NickeyJin/MyFirstCar/机械臂接入说明.md

# 机械臂模块接入说明

> 这份说明是给**底盘（麦轮）那部分**看的：我动了哪些文件、为什么动、你要注意什么。

---

## 一、加了什么

| 文件 | 内容 |
|---|---|
| `Core/Inc/servo.h`、`Core/Src/servo.c` | 舵机控制（3 关节、软限位、缓动、夹爪）|
| `Core/Inc/teach_only.h`、`Core/Src/teach_only.c` | 示教录制 / 回放 + Flash 存取 |

**4 个新文件，没有覆盖任何已有文件。**

---

## 二、动了哪些**已有**文件（一共 3 处，都很小）

### ① `CMakeLists.txt` —— 加了 4 行

```cmake
  Core/Src/app.c
  # ---- 机械臂舵机 + 示教录制回放（自带 TIM4 初始化，不依赖 CubeMX）----
  Core/Inc/servo.h
  Core/Inc/teach_only.h
  Core/Src/servo.c
  Core/Src/teach_only.c)
```

### ② `STM32F103xx_FLASH.ld` —— ⚠️ **FLASH 从 64K 改成 62K**

```ld
FLASH (rx) : ORIGIN = 0x8000000, LENGTH = 62K      ← 原来是 64K
```

**为什么必须改**：示教录制数据存在**最后 2 页 Flash**（`0x0800F800`，2 KB）。
如果不给程序区让出这 2 页，**一按"存"就会把程序自己擦掉**。

> ⚠️ **这个地址是写死的**，改一边就得改另一边，**别单独改回去**。

### ③ `Core/Src/app.c` —— 加了 3 行

```c
#include "teach_only.h"     /* 第 19 行，加在 #include "ps2.h" 后面 */

void app_init(void)
{
    dwt_init();
    ps2_init();
    teach_only_init();      /* ← 新增：舵机 + 从 Flash 读回上次录制 */
    chassis_init();
    ...
}

void app_task(void)
{
    ...
    ps2_poll();
    teach_only_poll();      /* ← 新增：★ 必须在 if (!ps2_ok) return; 之前 */
    if (!ps2_ok) { ... return; }
    ...
}
```

**★ 为什么 `teach_only_poll()` 要放在那句 `return` 之前**：
手柄一掉线，`app_task()` 就提前返回了。如果示教模块放在后面，**手柄掉线时机械臂的录制/回放也会跟着停摆**。

---

## 三、★ 它不抢你的资源

| 资源 | 归属 |
|---|---|
| **TIM1 / TIM2 / TIM3** | **你的**（电机 8 路 PWM）—— 本模块完全不碰 |
| **TIM4** | 本模块，**而且是自己初始化的**（不依赖 CubeMX）|
| **PB6 / PB7 / PB8** | 本模块（舵机信号），**不要占用** |
| PB9 | 空出备用 |
| **PA4 ~ PA7** | **共用**（PS2 手柄）—— 你的 `ps2_poll()` 已经在读了，本模块直接用 |
| **PA0~PA3 / PA8 / PA11 / PB0 / PB1** | 你的（电机）|
| **PC13（灯）** | ⚠️ **冲突**，见下 |
| **两个摇杆** | **你的** —— 本模块一个都不读 |
| **Flash 最后 2 页** | 本模块（录制数据）|

### ⚠️ PC13 状态灯冲突

你的 `app_task()` 里在写 PC13（`LED_ON()` / `LED_OFF()`），**示教模块也在写**（用来指示"待命/录制中/回放中"）。

两边每 20ms 各写一次 → **灯会闪得比较乱**。

**三个选择，你挑：**

| 方案 | 做法 |
|---|---|
| **A. 你的优先**（推荐）| 保持现状即可 —— 你的 LED 是每轮最后写的，基本会赢 |
| **B. 我的优先** | 把 `app_task()` 里的 `LED_ON()/LED_OFF()` 注释掉 |
| **C. 各用一个灯** | 我这边改到别的引脚（PB9 之类），你说一声我改 |

**目前按 A 处理，没有动你的 LED 代码。**

---

## 四、给底盘留的钩子（可选，但建议用）

写 Flash 时会**关中断 100~200ms**。电机 PWM 是硬件在发，会**保持最后的速度冲出去**。

在任意一个 `.c` 里写这个函数就自动生效（弱符号，不带 `__weak`）：

```c
void teach_before_save(void)
{
    chassis_stop();       /* 或者 ramp_vx = ramp_vy = ramp_w = 0; */
}
```

---

## 五、编译验证结果

```
warning = 0    error = 0

FLASH: 18848 B / 62 KB   （接入前 13240 B）
RAM:    3584 B / 20 KB

✅ arm_init  ✅ teach_only_init  ✅ teach_only_poll
✅ servo_poll  ✅ servo_hw_init   ✅ flash_save      全部链接进固件
```

## 六、接口速查

```c
/* 初始化（app_init 里调一次） */
teach_only_init();          /* 舵机 + 从 Flash 读回录制 */

/* 主循环（20ms 一次，必须在 if (!ps2_ok) return; 之前） */
teach_only_poll();          /* 读手柄按键 + 录制/回放推进 */

/* 可选：写 Flash 前让底盘停车 */
void teach_before_save(void);
```
