NickeyJin/MyFirstCar/(commit log)

2026-10-11 a little change
    修改了之前测试用的小数据
2026-10-11 随便测试一下
2026-10-12 最新的一版
2026-10-15 [arm] 接入机械臂：舵机控制 + 示教录制回放
    新增（不覆盖任何已有文件）：
    - Core/Inc/servo.h / Core/Src/servo.c 三关节舵机控制（软限位 + 缓动 + 夹爪）
    - Core/Inc/teach_only.h / Core/Src/teach_only.c 示教录制/回放 + Flash 存取
    修改（3 处）：
    - CMakeLists.txt 加 4 个文件
    - STM32F103xx_FLASH.ld FLASH 64K -> 62K（给录制数据让出最后 2 页）
    - Core/Src/app.c +include，app_init 加 teach_only_init()，
    app_task 在 if(!ps2_ok)return 之前加 teach_only_poll()
    资源占用：只用 TIM4(PB6/PB7/PB8) + PA4~PA7(共用 PS2) + Flash 最后 2 页
    TIM1/2/3 和摇杆全归底盘，未触碰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
2026-10-15 接入说明：删除第六节，章节重新编号
